Jaeger-Tim/VUB-Bachelor_Thesis_Lift_2022_2023/Photos and Videos/IMG_20230510_163319.jpg

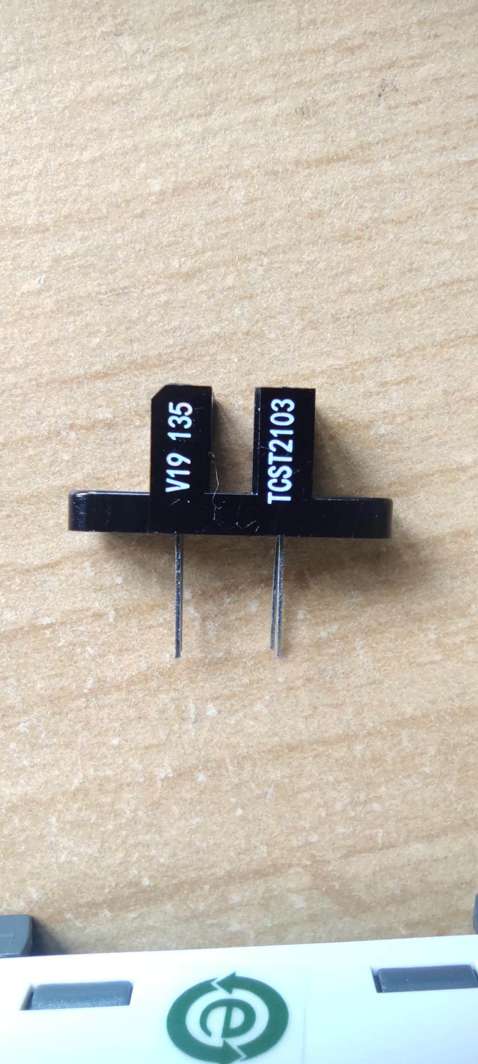
Photos and Videos/IMG_20230510_163319.jpg
