Jaeger-Tim/VUB-Bachelor_Thesis_Lift_2022_2023/README.md

This is a project for the VUB in Belgium.
