Jaeger-Tim/VUB-Bachelor_Thesis_Lift_2022_2023/Photos and Videos/2023-08-22/IMG_20230822_171855 - Copy.jpg

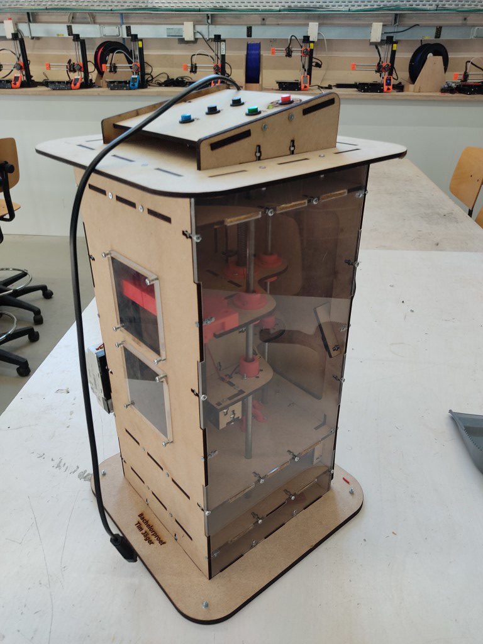
Photos and Videos/2023-08-22/IMG_20230822_171855 - Copy.jpg
