Jaeger-Tim/VUB-Bachelor_Thesis_Lift_2022_2023/Rendered_Images/Render_06_08_2023__16_59_High.png

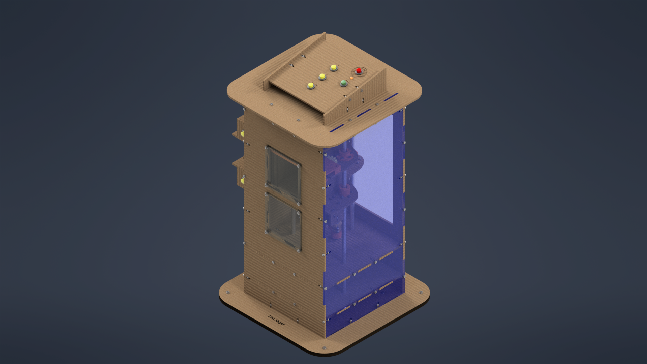
Rendered_Images/Render_06_08_2023__16_59_High.png
