Jaeger-Tim/VUB-Bachelor_Thesis_Lift_2022_2023/3D_Files/Lift_V2/V_156_1C25_STEP/V_156_1C25.step

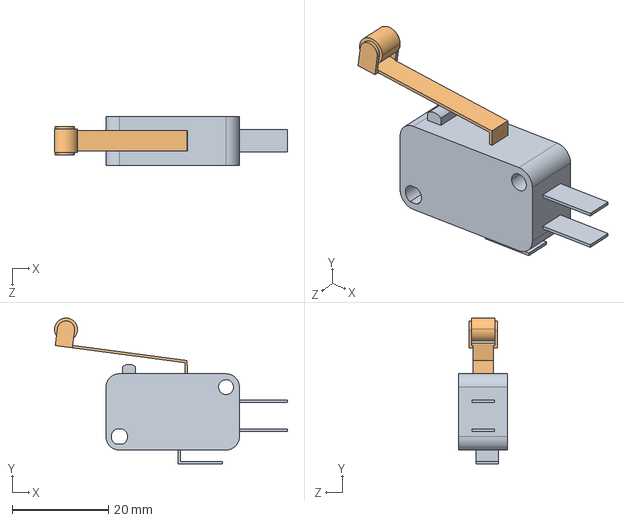
[picture p34: CAD file, 2023-08-13]
3D_Files/Lift_V2/V_156_1C25_STEP/V_156_1C25.step
48.5 x 30.4 x 10.3 mm
V_156_1C25_BASE
V_156_1C25_ACTUATOR
