Jaeger-Tim/VUB-Bachelor_Thesis_Lift_2022_2023/Production_Files/DXF/FloorButtonHolder_Side.dxf

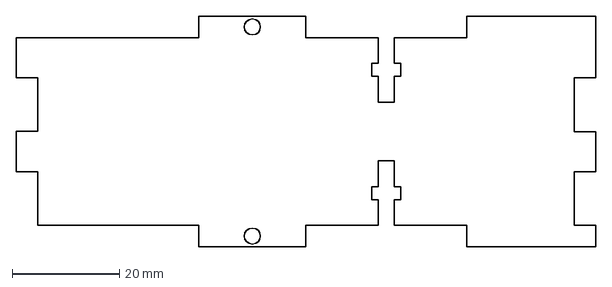
[picture p35: CAD file, 2023-08-13]
Production_Files/DXF/FloorButtonHolder_Side.dxf
108.0 x 43.0 mm
