Jaeger-Tim/VUB-Bachelor_Thesis_Lift_2022_2023/Production_Files/STL/Gear_Tight.stl

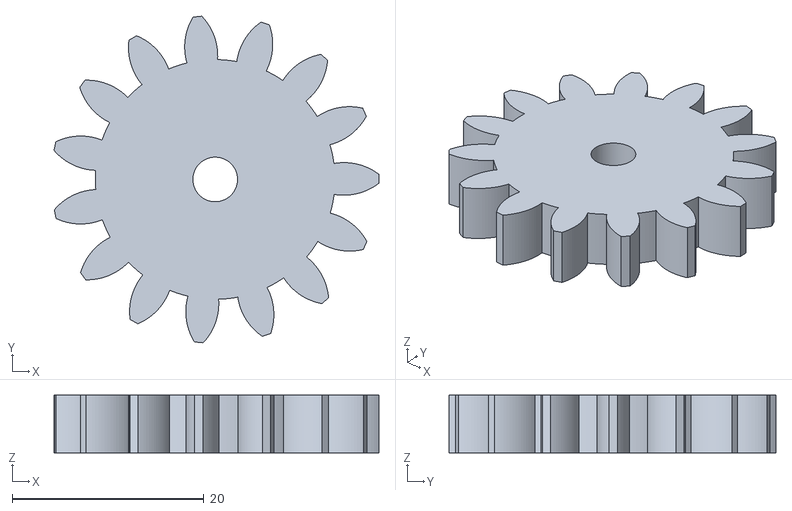
[picture p36: CAD file, 2023-08-22]
Production_Files/STL/Gear_Tight.stl
33.9 x 34.1 x 6.00
