Jaeger-Tim/VUB-Bachelor_Thesis_Lift_2022_2023/Production_Files/DXF/Wall_Left.dxf

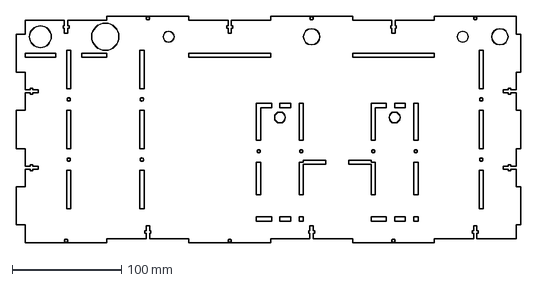
[picture p37: CAD file, 2023-08-13]
Production_Files/DXF/Wall_Left.dxf
462.0 x 208.0 mm
