Jaeger-Tim/VUB-Bachelor_Thesis_Lift_2022_2023/Production_Files/STL/Shaft_Shrunk.stl

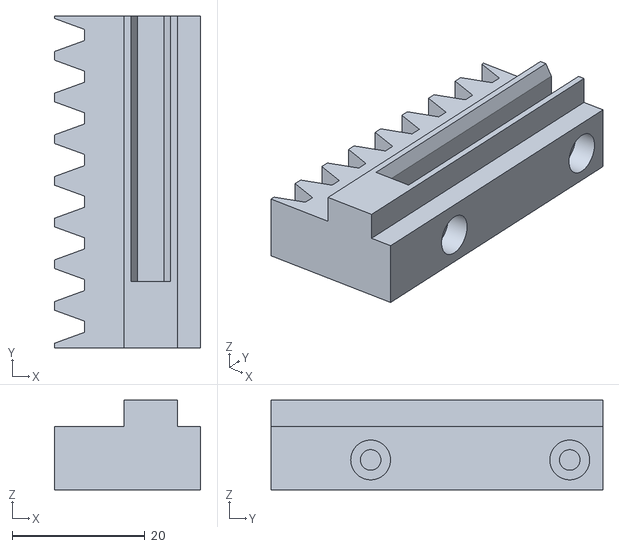
[picture p38: CAD file, 2023-08-22]
Production_Files/STL/Shaft_Shrunk.stl
22.0 x 50.0 x 13.5
