Jaeger-Tim/VUB-Bachelor_Thesis_Lift_2022_2023/Production_Files/DXF/Car_Rear.dxf

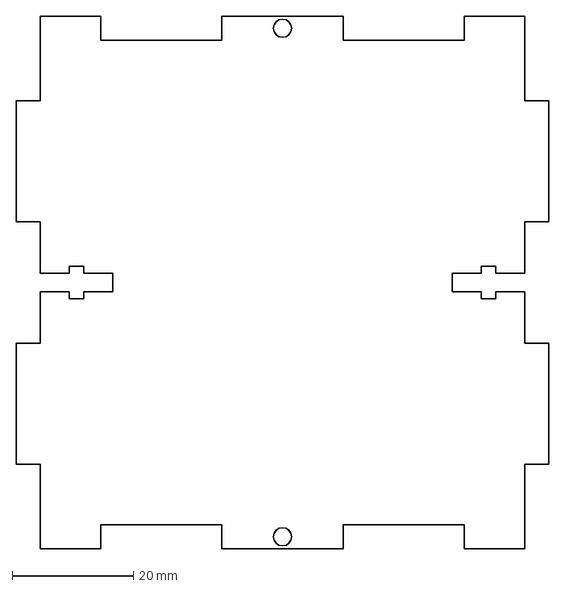
[picture p39: CAD file, 2023-08-13]
Production_Files/DXF/Car_Rear.dxf
88.0 x 88.0 mm
