Jaeger-Tim/VUB-Bachelor_Thesis_Lift_2022_2023/Production_Files/DXF/OnePlate.dxf

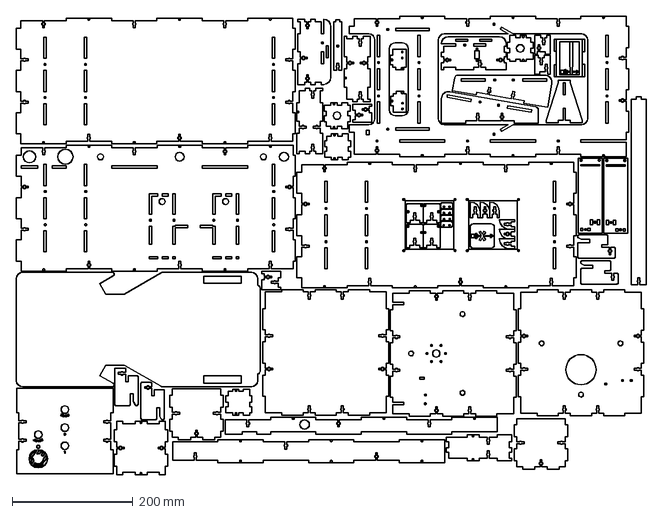
[picture p40: CAD file, 2023-08-13]
Production_Files/DXF/OnePlate.dxf
1042.2 x 757.9 mm
