Jaeger-Tim/VUB-Bachelor_Thesis_Lift_2022_2023/Production_Files/STL/Shaft_MIR.stl

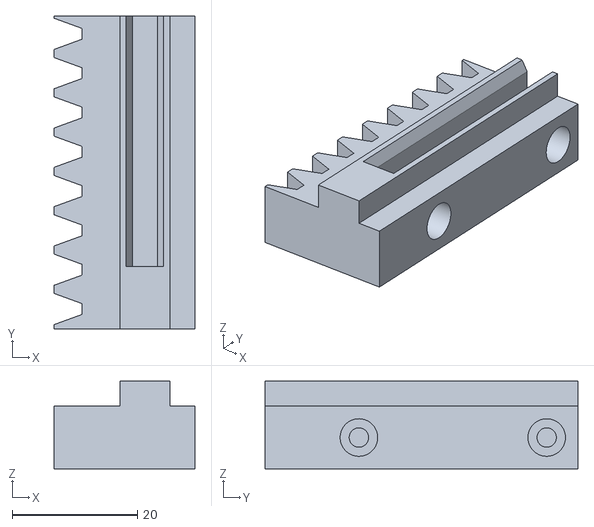
[picture p41: CAD file, 2023-08-13]
Production_Files/STL/Shaft_MIR.stl
22.5 x 50.0 x 14.0
