Jaeger-Tim/VUB-Bachelor_Thesis_Lift_2022_2023/Production_Files/STL/Receptacle.stl

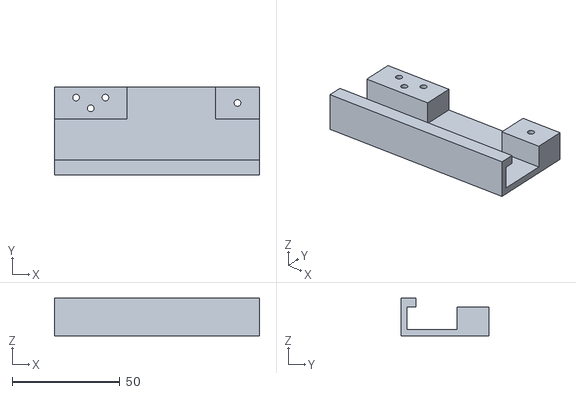
[picture p43: CAD file, 2023-08-13]
Production_Files/STL/Receptacle.stl
95.0 x 41.0 x 17.4
