Jaeger-Tim/VUB-Bachelor_Thesis_Lift_2022_2023/Production_Files/STL/Spindle_Block_Holder.stl

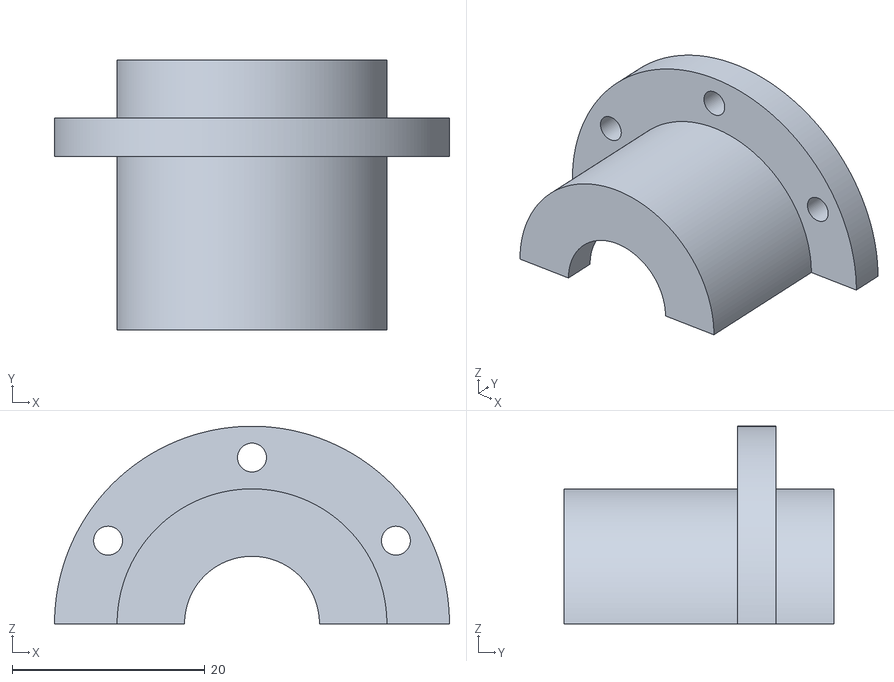
[picture p45: CAD file, 2023-08-13]
Production_Files/STL/Spindle_Block_Holder.stl
41.0 x 28.0 x 20.5
