Jaeger-Tim/VUB-Bachelor_Thesis_Lift_2022_2023/Production_Files/STL/SpindleAdaptor_A.stl

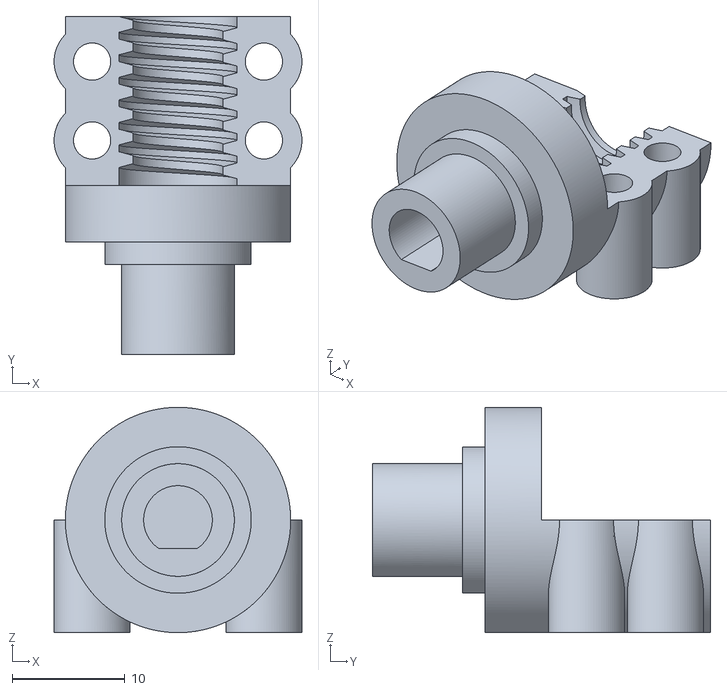
[picture p47: CAD file, 2023-08-13]
Production_Files/STL/SpindleAdaptor_A.stl
22.0 x 30.0 x 20.0
