Jaeger-Tim/VUB-Bachelor_Thesis_Lift_2022_2023/Production_Files/DXF/Cover_Back.dxf

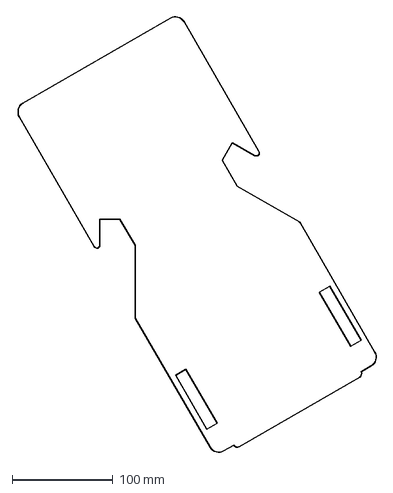
[picture p48: CAD file, 2023-08-13]
Production_Files/DXF/Cover_Back.dxf
357.6 x 433.4 mm
