Jaeger-Tim/VUB-Bachelor_Thesis_Lift_2022_2023/Production_Files/STL/LightGateCard.stl

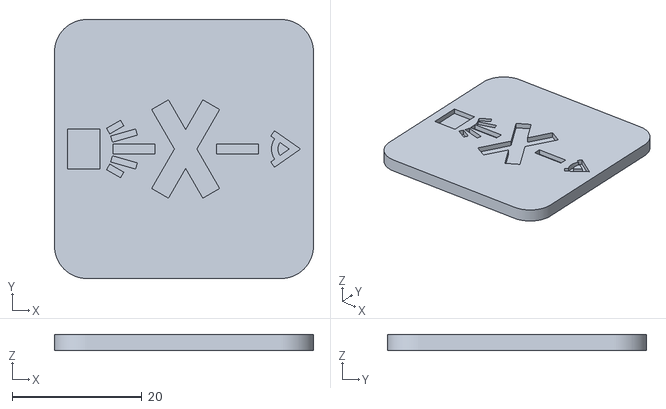
[picture p49: CAD file, 2023-08-13]
Production_Files/STL/LightGateCard.stl
40.0 x 40.0 x 2.50
