Jaeger-Tim/VUB-Bachelor_Thesis_Lift_2022_2023/Production_Files/DXF/Cover.dxf

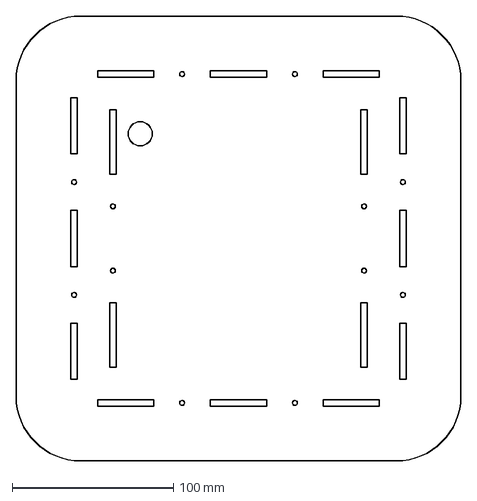
[picture p50: CAD file, 2023-08-13]
Production_Files/DXF/Cover.dxf
276.0 x 276.0 mm
