Jaeger-Tim/VUB-Bachelor_Thesis_Lift_2022_2023/Production_Files/STL/SpindleAdaptor_B.stl

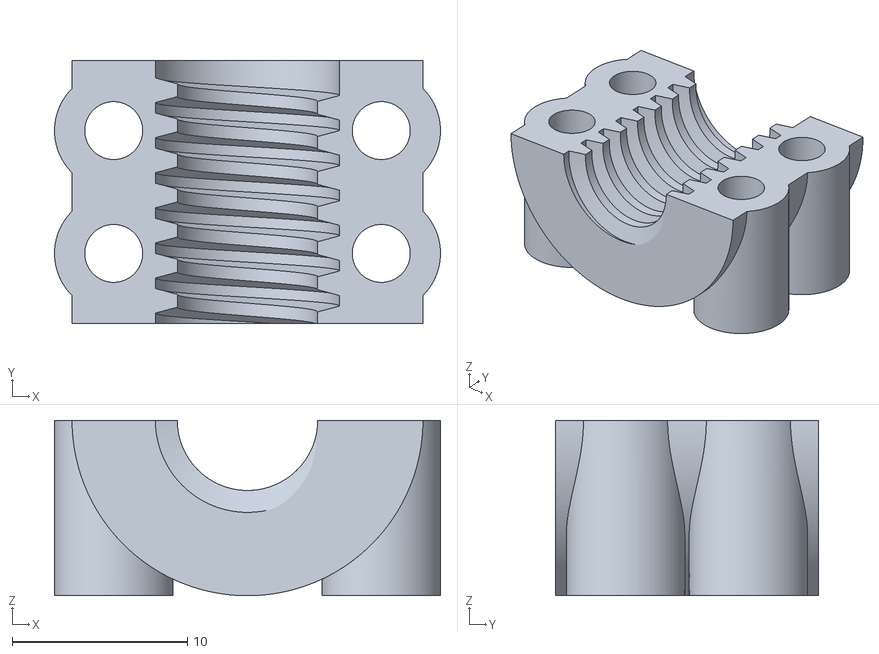
[picture p51: CAD file, 2023-08-13]
Production_Files/STL/SpindleAdaptor_B.stl
22.0 x 15.0 x 10.0
