Jaeger-Tim/VUB-Bachelor_Thesis_Lift_2022_2023/Production_Files/DXF/Car_Left.dxf

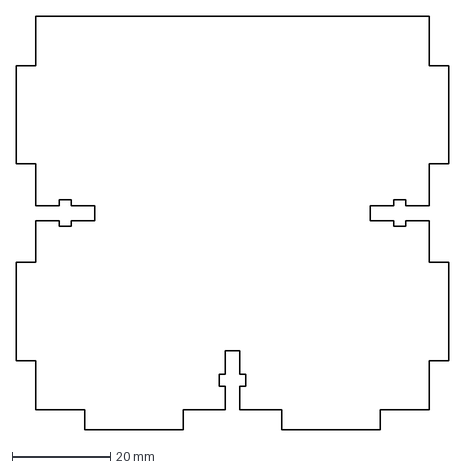
[picture p52: CAD file, 2023-08-13]
Production_Files/DXF/Car_Left.dxf
88.0 x 84.0 mm
