Jaeger-Tim/VUB-Bachelor_Thesis_Lift_2022_2023/Production_Files/STL/Bearing_Holder_MIR1.stl

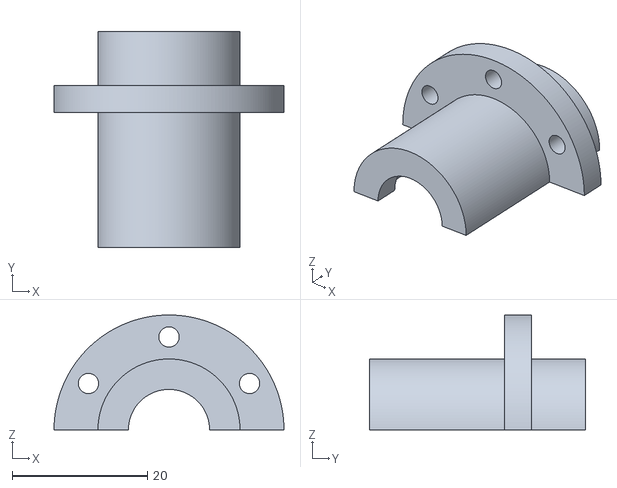
[picture p53: CAD file, 2023-08-13]
Production_Files/STL/Bearing_Holder_MIR1.stl
34.0 x 32.0 x 17.0
