Jaeger-Tim/VUB-Bachelor_Thesis_Lift_2022_2023/Production_Files/DXF/Cableduct_Side.dxf

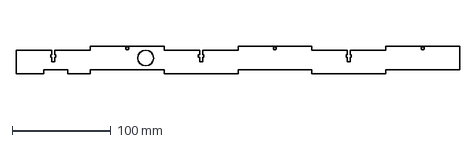
[picture p54: CAD file, 2023-08-13]
Production_Files/DXF/Cableduct_Side.dxf
450.0 x 28.0 mm
