Jaeger-Tim/VUB-Bachelor_Thesis_Lift_2022_2023/Production_Files/STL/allPrints.3mf

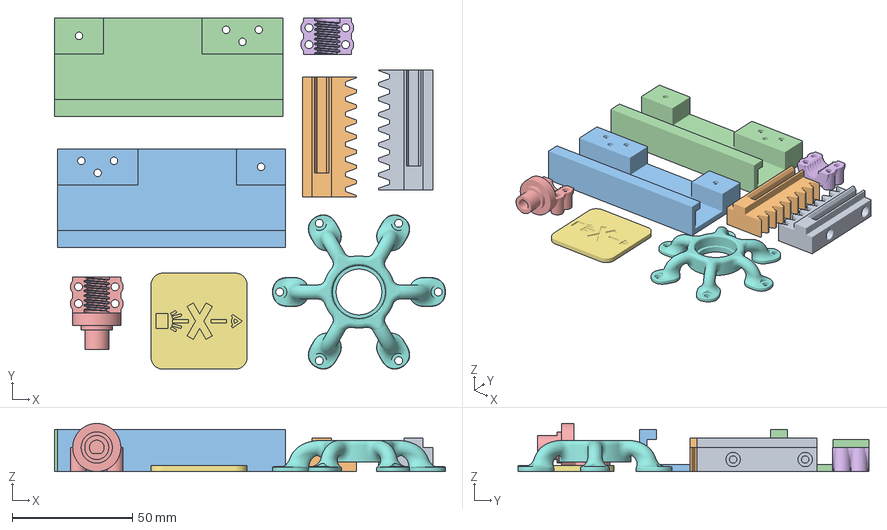
[picture p55: CAD file, 2023-08-13]
Production_Files/STL/allPrints.3mf
162.7 x 146.2 x 20.0 mm
Shaft_MIR.stl x 2
Receptacle.stl x 2
SpindleAdaptor_A.stl
SpindleAdaptor_B.stl
LightGateCard.stl
Spindle_Bearing_Holder.stl
