Jaeger-Tim/VUB-Bachelor_Thesis_Lift_2022_2023/Production_Files/DXF/Door_Right.dxf

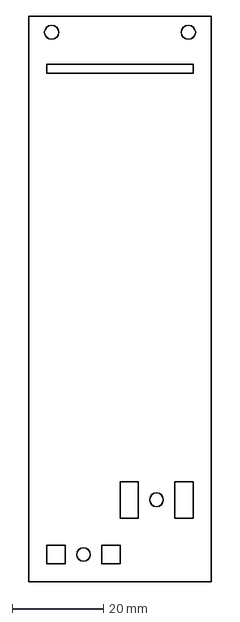
[picture p56: CAD file, 2023-08-13]
Production_Files/DXF/Door_Right.dxf
40.0 x 124.0 mm
