Jaeger-Tim/VUB-Bachelor_Thesis_Lift_2022_2023/Production_Files/DXF/Door_LimitSwitch_Holder_Side_2.dxf

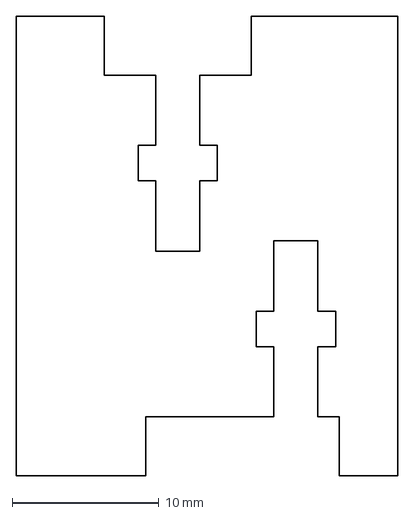
[picture p57: CAD file, 2023-08-13]
Production_Files/DXF/Door_LimitSwitch_Holder_Side_2.dxf
26.0 x 31.3 mm
