Jaeger-Tim/VUB-Bachelor_Thesis_Lift_2022_2023/Production_Files/DXF/SwitchHolder_Bottom_A.dxf

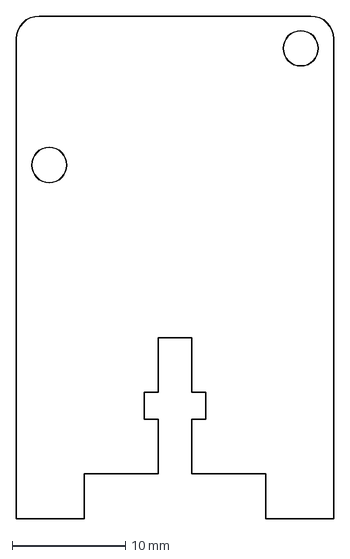
[picture p61: CAD file, 2023-08-13]
Production_Files/DXF/SwitchHolder_Bottom_A.dxf
28.0 x 44.4 mm
