Jaeger-Tim/VUB-Bachelor_Thesis_Lift_2022_2023/Production_Files/DXF/Cart_Floor.dxf

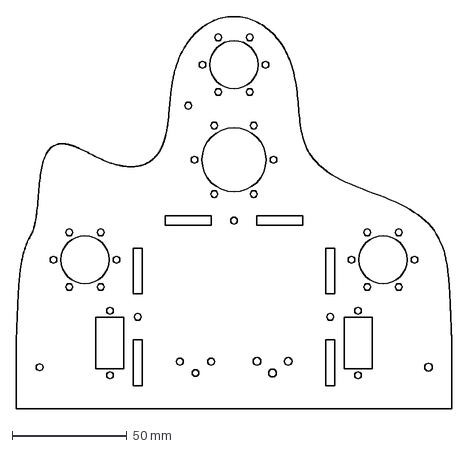
[picture p62: CAD file, 2023-08-13]
Production_Files/DXF/Cart_Floor.dxf
190.0 x 171.0 mm
