Jaeger-Tim/VUB-Bachelor_Thesis_Lift_2022_2023/Production_Files/DXF/SwitchHolder_Bottom_B.dxf

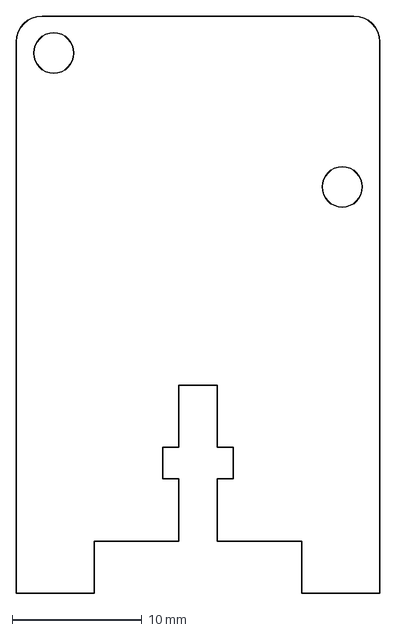
[picture p63: CAD file, 2023-08-13]
Production_Files/DXF/SwitchHolder_Bottom_B.dxf
28.0 x 44.4 mm
