Jaeger-Tim/VUB-Bachelor_Thesis_Lift_2022_2023/Production_Files/DXF/Cableduct_Cover.dxf

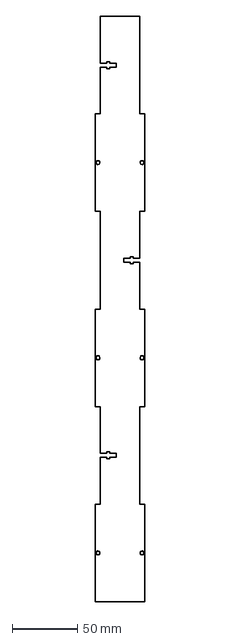
[picture p64: CAD file, 2023-08-13]
Production_Files/DXF/Cableduct_Cover.dxf
38.0 x 450.0 mm
