Jaeger-Tim/VUB-Bachelor_Thesis_Lift_2022_2023/Production_Files/DXF/Wall_Rear.dxf

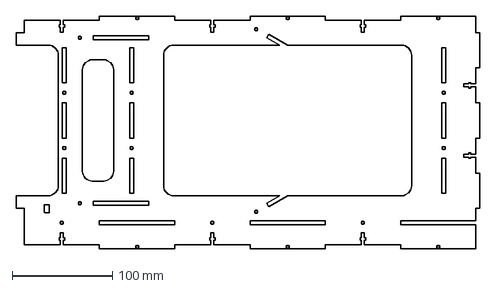
[picture p65: CAD file, 2023-08-13]
Production_Files/DXF/Wall_Rear.dxf
462.0 x 232.0 mm
