Jaeger-Tim/VUB-Bachelor_Thesis_Lift_2022_2023/Production_Files/DXF/LightGate_Plate.dxf

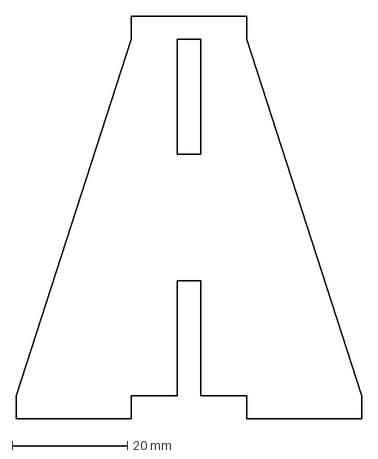
[picture p66: CAD file, 2023-08-13]
Production_Files/DXF/LightGate_Plate.dxf
60.0 x 70.0 mm
