Jaeger-Tim/VUB-Bachelor_Thesis_Lift_2022_2023/Production_Files/DXF/Door_LimitSwitch_Offset.dxf

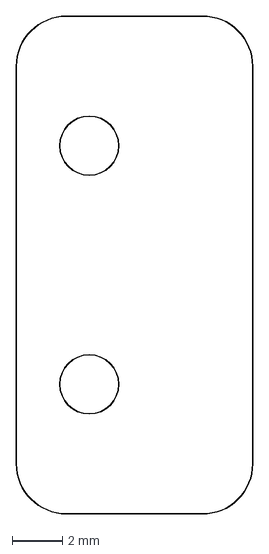
[picture p67: CAD file, 2023-08-13]
Production_Files/DXF/Door_LimitSwitch_Offset.dxf
9.40 x 19.8 mm
