Jaeger-Tim/VUB-Bachelor_Thesis_Lift_2022_2023/Production_Files/DXF/Door_LimitSwitch_Holder_Plate_MIR.dxf

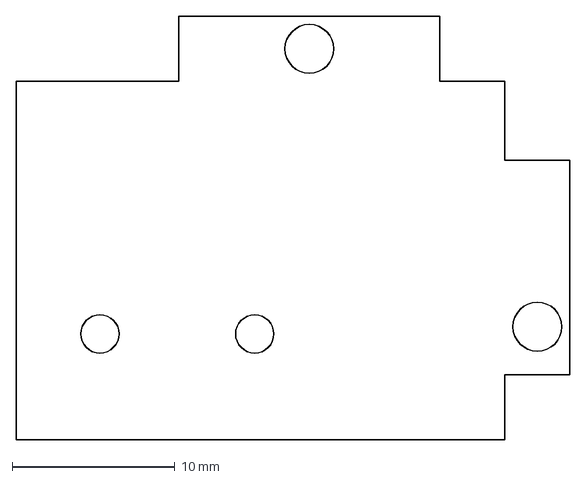
[picture p68: CAD file, 2023-08-13]
Production_Files/DXF/Door_LimitSwitch_Holder_Plate_MIR.dxf
34.0 x 26.0 mm
