Jaeger-Tim/VUB-Bachelor_Thesis_Lift_2022_2023/Production_Files/DXF/Floor.dxf

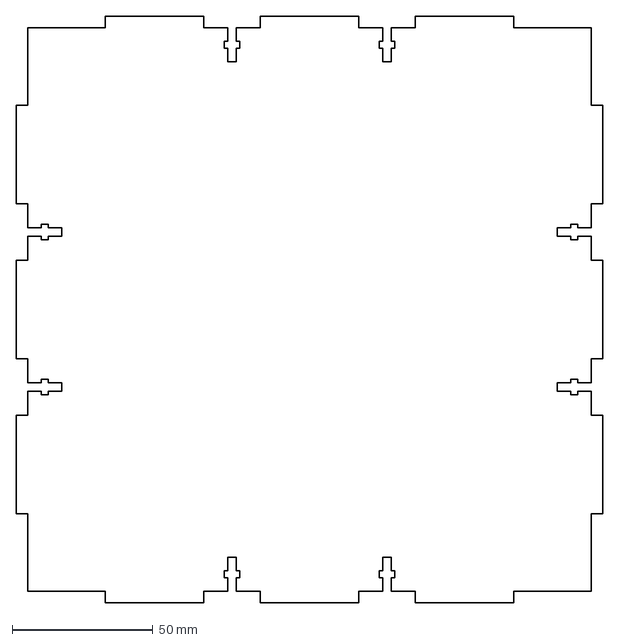
[picture p73: CAD file, 2023-08-13]
Production_Files/DXF/Floor.dxf
208.0 x 208.0 mm
