Jaeger-Tim/VUB-Bachelor_Thesis_Lift_2022_2023/Production_Files/DXF/Reed_Rail.dxf

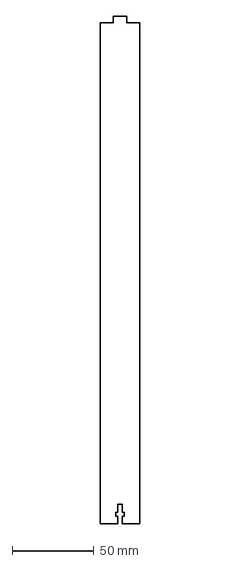
[picture p74: CAD file, 2023-08-13]
Production_Files/DXF/Reed_Rail.dxf
24.0 x 311.0 mm
