Jaeger-Tim/VUB-Bachelor_Thesis_Lift_2022_2023/Production_Files/DXF/Door_LimitSwitch_Holder_Side_1.dxf

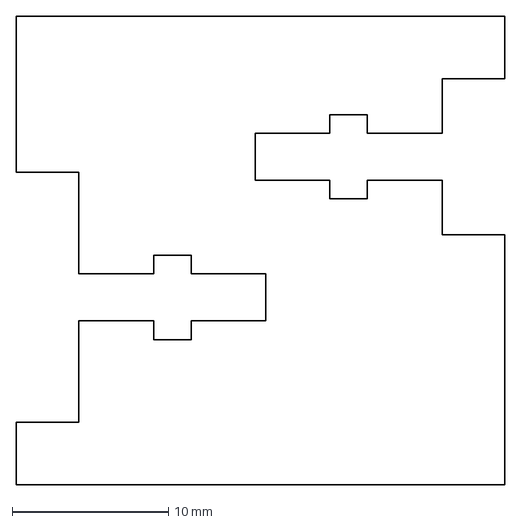
[picture p75: CAD file, 2023-08-13]
Production_Files/DXF/Door_LimitSwitch_Holder_Side_1.dxf
31.3 x 30.0 mm
