Jaeger-Tim/VUB-Bachelor_Thesis_Lift_2022_2023/Production_Files/DXF/Baseplate_Bottom.dxf

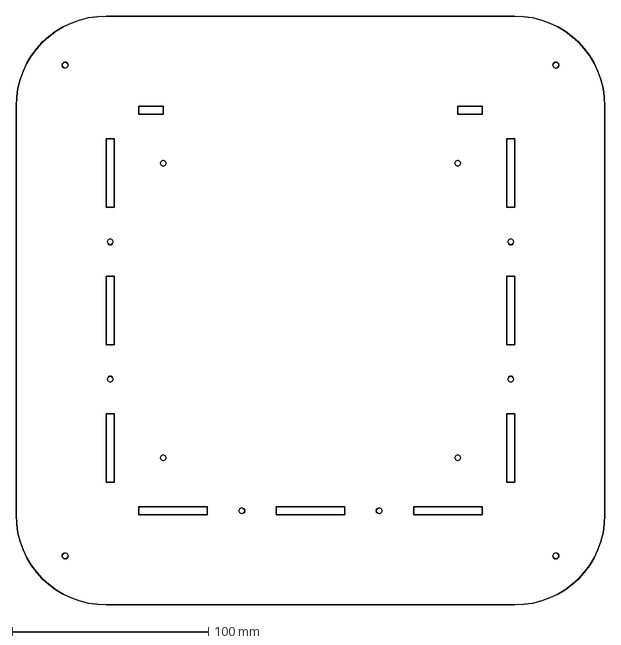
[picture p77: CAD file, 2023-08-13]
Production_Files/DXF/Baseplate_Bottom.dxf
300.0 x 300.0 mm
