Jaeger-Tim/VUB-Bachelor_Thesis_Lift_2022_2023/Production_Files/DXF/FloorButtonHolder_Front.dxf

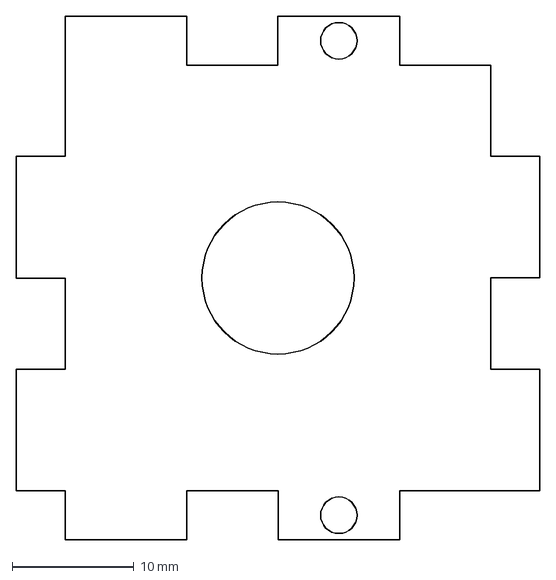
[picture p80: CAD file, 2023-08-13]
Production_Files/DXF/FloorButtonHolder_Front.dxf
43.0 x 43.0 mm
