Jaeger-Tim/VUB-Bachelor_Thesis_Lift_2022_2023/Production_Files/DXF/Pannel.dxf

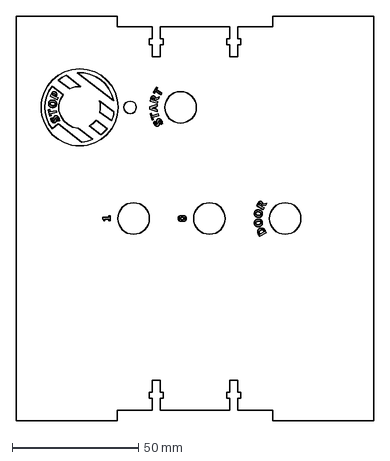
[picture p82: CAD file, 2023-08-13]
Production_Files/DXF/Pannel.dxf
141.4 x 160.0 mm
