Jaeger-Tim/VUB-Bachelor_Thesis_Lift_2022_2023/Production_Files/DXF/SwitchHolder_Top_B.dxf

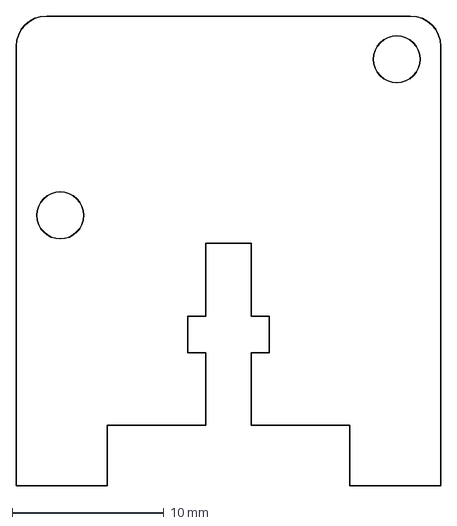
[picture p83: CAD file, 2023-08-13]
Production_Files/DXF/SwitchHolder_Top_B.dxf
28.0 x 31.0 mm
