Jaeger-Tim/VUB-Bachelor_Thesis_Lift_2022_2023/Production_Files/DXF/CoverHolder_Left.dxf

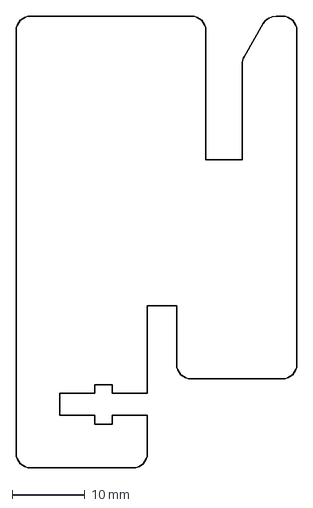
[picture p84: CAD file, 2023-08-13]
Production_Files/DXF/CoverHolder_Left.dxf
38.5 x 61.9 mm
