Jaeger-Tim/VUB-Bachelor_Thesis_Lift_2022_2023/Production_Files/DXF/Door_LimitSwitch_Holder_Side_2_B.dxf

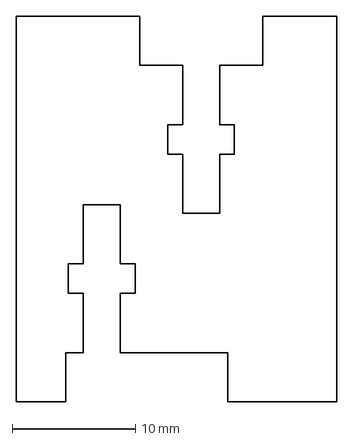
[picture p85: CAD file, 2023-08-13]
Production_Files/DXF/Door_LimitSwitch_Holder_Side_2_B.dxf
26.0 x 31.3 mm
