Jaeger-Tim/VUB-Bachelor_Thesis_Lift_2022_2023/Production_Files/DXF/LightGate_Door.dxf

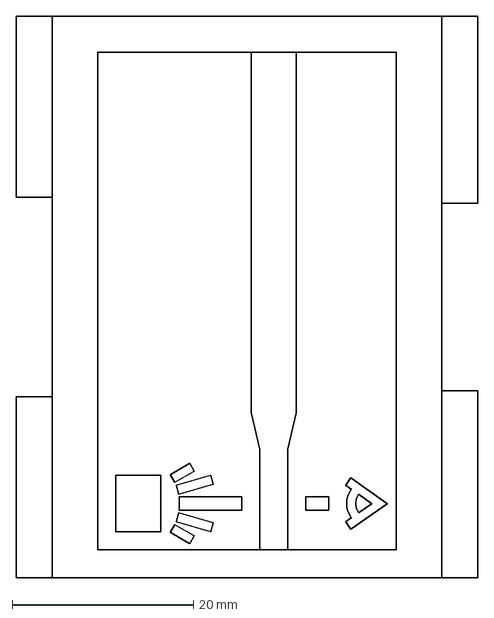
[picture p86: CAD file, 2023-08-13]
Production_Files/DXF/LightGate_Door.dxf
51.0 x 62.0 mm
