Jaeger-Tim/VUB-Bachelor_Thesis_Lift_2022_2023/Production_Files/DXF/Baseplate_Top.dxf

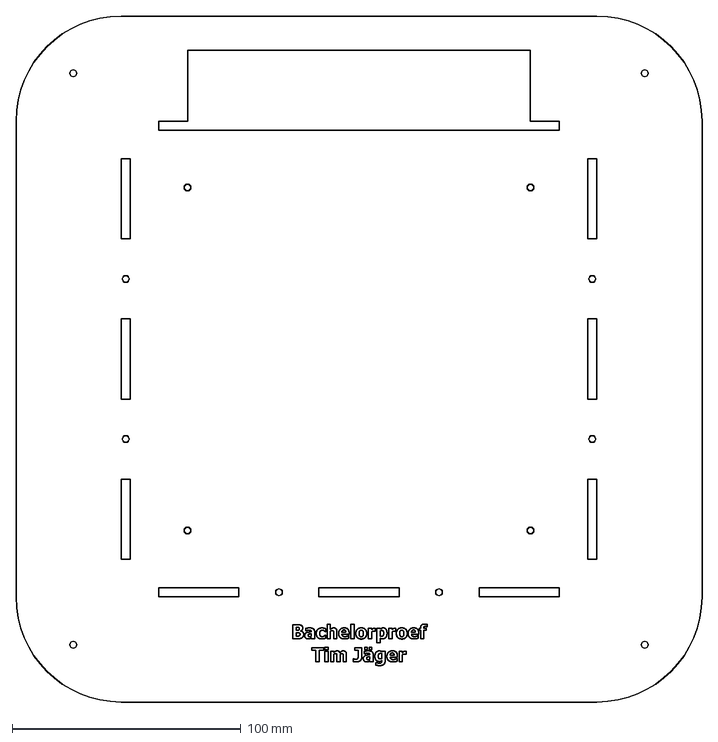
[picture p87: CAD file, 2023-08-13]
Production_Files/DXF/Baseplate_Top.dxf
300.0 x 300.0 mm
