Jaeger-Tim/VUB-Bachelor_Thesis_Lift_2022_2023/Production_Files/DXF/Magnet_Holder.dxf

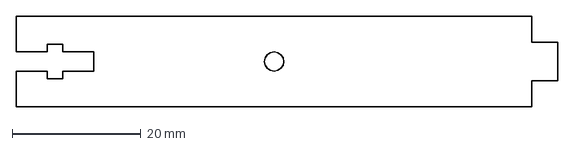
[picture p88: CAD file, 2023-08-13]
Production_Files/DXF/Magnet_Holder.dxf
84.0 x 14.0 mm
