Jaeger-Tim/VUB-Bachelor_Thesis_Lift_2022_2023/Production_Files/DXF/FloorButtonHolder_Bottom_A.dxf

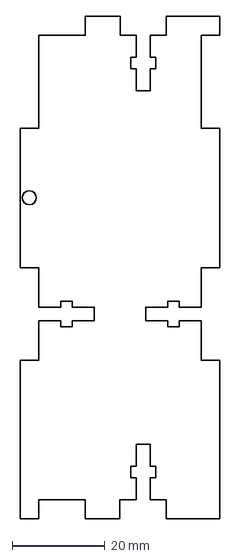
[picture p89: CAD file, 2023-08-13]
Production_Files/DXF/FloorButtonHolder_Bottom_A.dxf
43.0 x 108.0 mm
