Jaeger-Tim/VUB-Bachelor_Thesis_Lift_2022_2023/Production_Files/DXF/Wall_Front.dxf

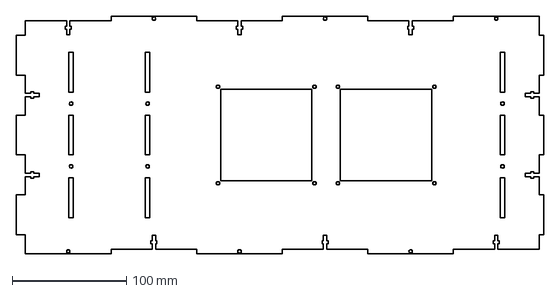
[picture p90: CAD file, 2023-08-13]
Production_Files/DXF/Wall_Front.dxf
462.0 x 208.0 mm
