Jaeger-Tim/VUB-Bachelor_Thesis_Lift_2022_2023/Production_Files/DXF/Pannel_Side_Left.dxf

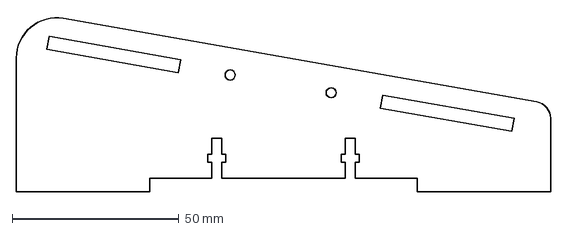
[picture p91: CAD file, 2023-08-13]
Production_Files/DXF/Pannel_Side_Left.dxf
160.0 x 52.5 mm
