Jaeger-Tim/VUB-Bachelor_Thesis_Lift_2022_2023/Production_Files/DXF/Lever.dxf

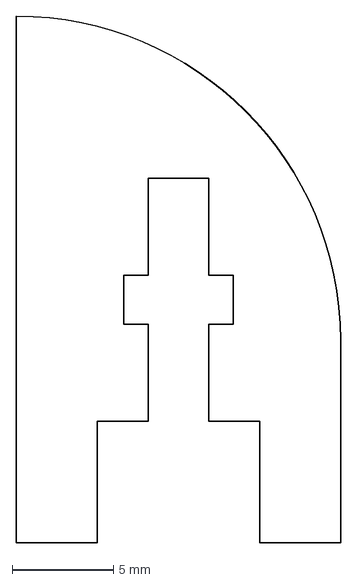
[picture p92: CAD file, 2023-08-13]
Production_Files/DXF/Lever.dxf
16.0 x 26.0 mm
