Jaeger-Tim/VUB-Bachelor_Thesis_Lift_2022_2023/Production_Files/DXF/FloorButtonHOlder_Back.dxf

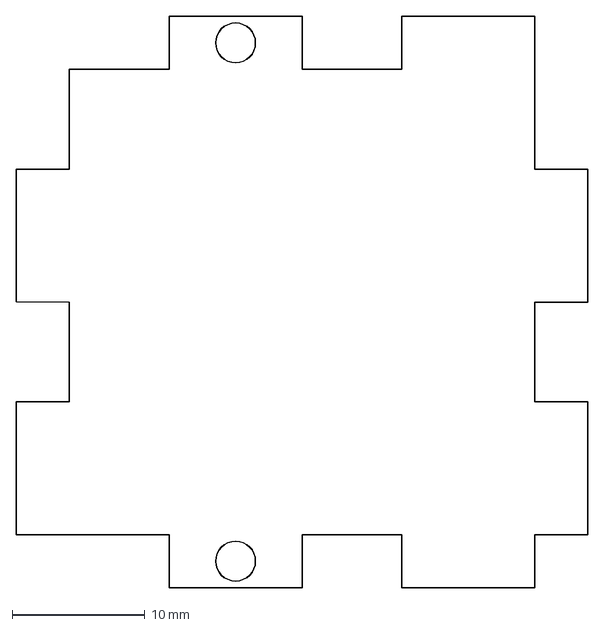
[picture p93: CAD file, 2023-08-13]
Production_Files/DXF/FloorButtonHOlder_Back.dxf
43.0 x 43.0 mm
