Jaeger-Tim/VUB-Bachelor_Thesis_Lift_2022_2023/(list of files, cad)

Other CAD files:
Production_Files/STL/Gear.stl
Production_Files/STL/Bearing_Holder.stl
3D_Files/Lift_V2/Baseplate_V1.ipt
3D_Files/Lift_V2/Baseplate_face.ipt
3D_Files/Lift_V2/Bearing_ASM.iam
3D_Files/Lift_V2/Bearing_ASM_MIR.iam
3D_Files/Lift_V2/Bearing_ASM_MIR1.iam
3D_Files/Lift_V2/Bearing_Holder.ipt
3D_Files/Lift_V2/Bearing_Holder_MIR.ipt
3D_Files/Lift_V2/Bearing_Holder_MIR1.ipt
3D_Files/Lift_V2/Button_Green.ipt
3D_Files/Lift_V2/Button_Red.ipt
3D_Files/Lift_V2/Button_Yellow.ipt
3D_Files/Lift_V2/Cableduct_Cover.ipt
3D_Files/Lift_V2/Cableduct_Side.ipt
3D_Files/Lift_V2/Car_ASM.iam
3D_Files/Lift_V2/Car_Left.ipt
3D_Files/Lift_V2/Car_Rear.ipt
3D_Files/Lift_V2/Cart_Floor.ipt
3D_Files/Lift_V2/Cart_Floor_Bottom.ipt
3D_Files/Lift_V2/Cover.ipt
3D_Files/Lift_V2/CoverHolder.ipt
3D_Files/Lift_V2/Cover_Back.ipt
3D_Files/Lift_V2/Door.ipt
3D_Files/Lift_V2/Door_LimitSwitch_Holder_Plate.ipt
3D_Files/Lift_V2/Door_LimitSwitch_Holder_Plate_MIR.ipt
3D_Files/Lift_V2/Door_LimitSwitch_Holder_Side_1.ipt
3D_Files/Lift_V2/Door_LimitSwitch_Holder_Side_1_MIR.ipt
3D_Files/Lift_V2/Door_LimitSwitch_Holder_Side_2.ipt
3D_Files/Lift_V2/Door_LimitSwitch_Holder_Side_2_MIR.ipt
3D_Files/Lift_V2/Door_LimitSwitch_Offset.ipt
3D_Files/Lift_V2/Door_MIR.ipt
3D_Files/Lift_V2/Floor.ipt
3D_Files/Lift_V2/FloorButtonHolder_Back.ipt
3D_Files/Lift_V2/FloorButtonHolder_Bottom_A.ipt
3D_Files/Lift_V2/FloorButtonHolder_Bottom_B.ipt
3D_Files/Lift_V2/FloorButtonHolder_Front.ipt
3D_Files/Lift_V2/FloorButtonHolder_Side.ipt
3D_Files/Lift_V2/FloorButtonHolder_Top_A.ipt
3D_Files/Lift_V2/FloorButtonHolder_Top_B.ipt
3D_Files/Lift_V2/Floor_Bottom.ipt
3D_Files/Lift_V2/Floor_Top.ipt
3D_Files/Lift_V2/Gear.ipt
3D_Files/Lift_V2/Gear_MIR.ipt
3D_Files/Lift_V2/Guide Rod.ipt
3D_Files/Lift_V2/ISO 1207 - M3 x 12.ipt
3D_Files/Lift_V2/ISO 4032 - M3 - ISO.ipt
3D_Files/Lift_V2/ISO 7089 - 3 - 140 HV(1).ipt
3D_Files/Lift_V2/LED5mm.ipt
3D_Files/Lift_V2/Lever.ipt
3D_Files/Lift_V2/Lever_MIR.ipt
3D_Files/Lift_V2/Lift_V2.iam
3D_Files/Lift_V2/LightGateCard.ipt
3D_Files/Lift_V2/LightGate_Door.ipt
3D_Files/Lift_V2/LightGate_Plate.ipt
3D_Files/Lift_V2/LimitSwitch_Big.iam
3D_Files/Lift_V2/LimitSwitch_Small.ipt
3D_Files/Lift_V2/LinearBearing.ipt
3D_Files/Lift_V2/LinearBearing_MIR.ipt
3D_Files/Lift_V2/LinearBearing_MIR1.ipt
3D_Files/Lift_V2/Magnet_Holder.ipt
3D_Files/Lift_V2/Motor24V.ipt
3D_Files/Lift_V2/OldVersions/Baseplate_V1.0009.ipt
3D_Files/Lift_V2/OldVersions/Baseplate_deriveTest.0003.ipt
3D_Files/Lift_V2/OldVersions/Baseplate_face.0008.ipt
3D_Files/Lift_V2/OldVersions/Bearing_ASM.0004.iam
3D_Files/Lift_V2/OldVersions/Bearing_ASM_MIR1.0002.iam
3D_Files/Lift_V2/OldVersions/Bearing_Holder.0003.ipt
3D_Files/Lift_V2/OldVersions/Bearing_Holder_MIR1.0001.ipt
3D_Files/Lift_V2/OldVersions/Cableduct_Cover.0002.ipt
3D_Files/Lift_V2/OldVersions/Cableduct_Side.0004.ipt
3D_Files/Lift_V2/OldVersions/Car_ASM.0057.iam
3D_Files/Lift_V2/OldVersions/Car_Left.0003.ipt
3D_Files/Lift_V2/OldVersions/Car_Rear.0006.ipt
3D_Files/Lift_V2/OldVersions/Cart_Floor.0015.ipt
3D_Files/Lift_V2/OldVersions/Cart_Floor_Bottom.0017.ipt
3D_Files/Lift_V2/OldVersions/Cover.0003.ipt
3D_Files/Lift_V2/OldVersions/CoverHolder.0008.ipt
3D_Files/Lift_V2/OldVersions/Cover_Back.0003.ipt
3D_Files/Lift_V2/OldVersions/Door.0018.ipt
3D_Files/Lift_V2/OldVersions/Door_LimitSwitch_Holder_Plate.0002.ipt
3D_Files/Lift_V2/OldVersions/Door_LimitSwitch_Holder_Plate_MIR.0001.ipt
3D_Files/Lift_V2/OldVersions/Door_LimitSwitch_Holder_Side_1.0003.ipt
3D_Files/Lift_V2/OldVersions/Door_LimitSwitch_Holder_Side_1_MIR.0001.ipt
3D_Files/Lift_V2/OldVersions/Door_LimitSwitch_Holder_Side_2.0003.ipt
3D_Files/Lift_V2/OldVersions/Door_LimitSwitch_Holder_Side_2_MIR.0001.ipt
3D_Files/Lift_V2/OldVersions/Door_LimitSwitch_Offset.0004.ipt
3D_Files/Lift_V2/OldVersions/Door_MIR.0008.ipt
3D_Files/Lift_V2/OldVersions/Floor.0005.ipt
3D_Files/Lift_V2/OldVersions/FloorButtonHolder_Back.0006.ipt
3D_Files/Lift_V2/OldVersions/FloorButtonHolder_Bottom_A.0005.ipt
3D_Files/Lift_V2/OldVersions/FloorButtonHolder_Bottom_B.0009.ipt
3D_Files/Lift_V2/OldVersions/FloorButtonHolder_Front.0005.ipt
3D_Files/Lift_V2/OldVersions/FloorButtonHolder_Side.0011.ipt
3D_Files/Lift_V2/OldVersions/FloorButtonHolder_Top_A.0006.ipt
3D_Files/Lift_V2/OldVersions/FloorButtonHolder_Top_B.0013.ipt
3D_Files/Lift_V2/OldVersions/Floor_Bottom.0012.ipt
3D_Files/Lift_V2/OldVersions/Floor_Top.0009.ipt
3D_Files/Lift_V2/OldVersions/Gear.0010.ipt
3D_Files/Lift_V2/OldVersions/Guide Rod.0003.ipt
3D_Files/Lift_V2/OldVersions/Lever.0009.ipt
3D_Files/Lift_V2/OldVersions/Lift_V2.0145.iam
3D_Files/Lift_V2/OldVersions/LightGateCard.0013.ipt
3D_Files/Lift_V2/OldVersions/LightGate_Door.0021.ipt
3D_Files/Lift_V2/OldVersions/LightGate_Plate.0005.ipt
3D_Files/Lift_V2/OldVersions/LimitSwitch_Big.0004.iam
3D_Files/Lift_V2/OldVersions/LimitSwitch_Small.0003.ipt
3D_Files/Lift_V2/OldVersions/LinearBearing.0002.ipt
3D_Files/Lift_V2/OldVersions/Magnet_Holder.0002.ipt
3D_Files/Lift_V2/OldVersions/Motor24V.0002.ipt
3D_Files/Lift_V2/OldVersions/Panel.0011.ipt
3D_Files/Lift_V2/OldVersions/Pannel_Side.0004.ipt
3D_Files/Lift_V2/OldVersions/Protector_80x80.0002.ipt
3D_Files/Lift_V2/OldVersions/Receptacle.0017.ipt
3D_Files/Lift_V2/OldVersions/Receptacle_MIR.0002.ipt
3D_Files/Lift_V2/OldVersions/Reed_Rail.0002.ipt
3D_Files/Lift_V2/OldVersions/Servo_Motor.0004.ipt
3D_Files/Lift_V2/OldVersions/Shaft.0012.ipt
3D_Files/Lift_V2/OldVersions/Shaft_MIR.0002.ipt
3D_Files/Lift_V2/OldVersions/SpindleAdaptor_A.0015.ipt
3D_Files/Lift_V2/OldVersions/SpindleAdaptor_B.0010.ipt
3D_Files/Lift_V2/OldVersions/SpindleBlock.0003.ipt
3D_Files/Lift_V2/OldVersions/Spindle_Block_ASM.0004.iam
3D_Files/Lift_V2/OldVersions/Spindle_Block_ASM_MIR.0002.iam
3D_Files/Lift_V2/OldVersions/Spindle_Block_Holder.0001.ipt
3D_Files/Lift_V2/OldVersions/Spindle_Block_Holder_MIR.0001.ipt
3D_Files/Lift_V2/OldVersions/Spindle_Rod.0006.ipt
3D_Files/Lift_V2/OldVersions/SwitchHolder_Bottom.0006.ipt
3D_Files/Lift_V2/OldVersions/SwitchHolder_Top.0004.ipt
3D_Files/Lift_V2/OldVersions/Wall.0010.ipt
3D_Files/Lift_V2/OldVersions/Wall_Front.0010.ipt
3D_Files/Lift_V2/OldVersions/Wall_Left.0012.ipt
3D_Files/Lift_V2/OldVersions/Wall_rear.0011.ipt
3D_Files/Lift_V2/Panel.ipt
3D_Files/Lift_V2/Pannel_Side.ipt
3D_Files/Lift_V2/Protector_80x80.ipt
3D_Files/Lift_V2/Receptacle.ipt
3D_Files/Lift_V2/Receptacle_MIR.ipt
3D_Files/Lift_V2/Reed_Rail.ipt
3D_Files/Lift_V2/Servo_Motor.ipt
3D_Files/Lift_V2/Servo_Motor_MIR.ipt
3D_Files/Lift_V2/Shaft.ipt
3D_Files/Lift_V2/Shaft_MIR.ipt
3D_Files/Lift_V2/SpindleAdaptor_A.ipt
3D_Files/Lift_V2/SpindleAdaptor_B.ipt
3D_Files/Lift_V2/SpindleBlock.ipt
3D_Files/Lift_V2/SpindleBlock_MIR.ipt
3D_Files/Lift_V2/Spindle_Block_ASM.iam
3D_Files/Lift_V2/Spindle_Block_ASM_MIR.iam
3D_Files/Lift_V2/Spindle_Block_Holder.ipt
3D_Files/Lift_V2/Spindle_Block_Holder_MIR.ipt
3D_Files/Lift_V2/Spindle_Rod.ipt
3D_Files/Lift_V2/SwitchHolder_Bottom.ipt
3D_Files/Lift_V2/SwitchHolder_Top.ipt
3D_Files/Lift_V2/V_156_1C25_STEP/V_156_1C25/OldVersions/V_156_1C25_ACTUATOR.0001.ipt
3D_Files/Lift_V2/V_156_1C25_STEP/V_156_1C25/OldVersions/V_156_1C25_BASE.0001.ipt
3D_Files/Lift_V2/V_156_1C25_STEP/V_156_1C25/V_156_1C25_ACTUATOR.ipt
3D_Files/Lift_V2/V_156_1C25_STEP/V_156_1C25/V_156_1C25_BASE.ipt
3D_Files/Lift_V2/Wall.ipt
3D_Files/Lift_V2/Wall_Front.ipt
3D_Files/Lift_V2/Wall_Left.ipt
3D_Files/Lift_V2/Wall_Right.ipt
3D_Files/Lift_V2/Wall_rear.ipt
Production_Files/DXF/LightGateCard.dxf
Production_Files/DXF/OnePlate.idw
