Jaeger-Tim/VUB-Bachelor_Thesis_Lift_2022_2023/Elektronica/SCH_VUB Bachelorproef_2023-08-22.pdf

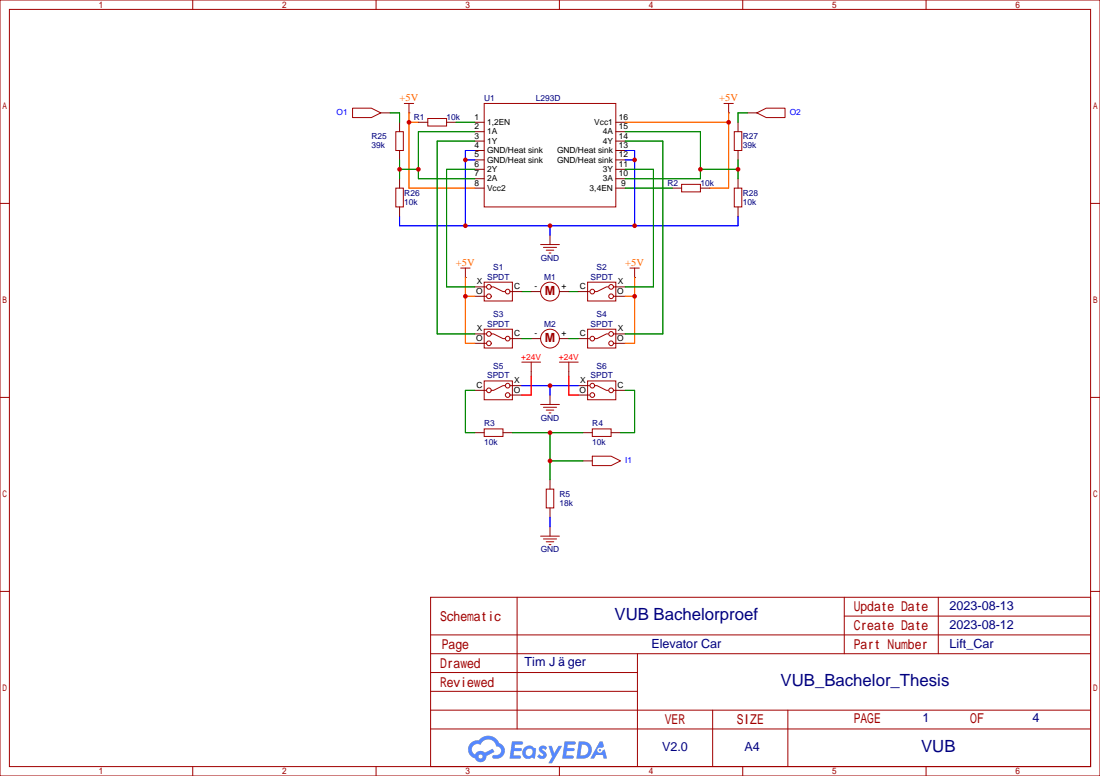
[picture p94: page 1]

I1 1

O4 14

I3 3

O2 12

IB 5

10 ID 7

IE 8
+

9

IC 6

O1 11

I4 4

O3 13

I2 2

O+ 15

CD12S 24V/DC

PLC1 +24V

+24V

GND

O1 | O2

ID

I1

O3 | O4 I2
I3 | I4
IB | IE

IC

### Reviewed

### Drawed

### Create Date Part Number

### Schematic

### Update Date

### Page

## Tim J ger

# VUB_Bachelor_Thesis

2023-08-12

# 2023-08-12 VUB Bachelorproef

## Lift_PLC

## PLC

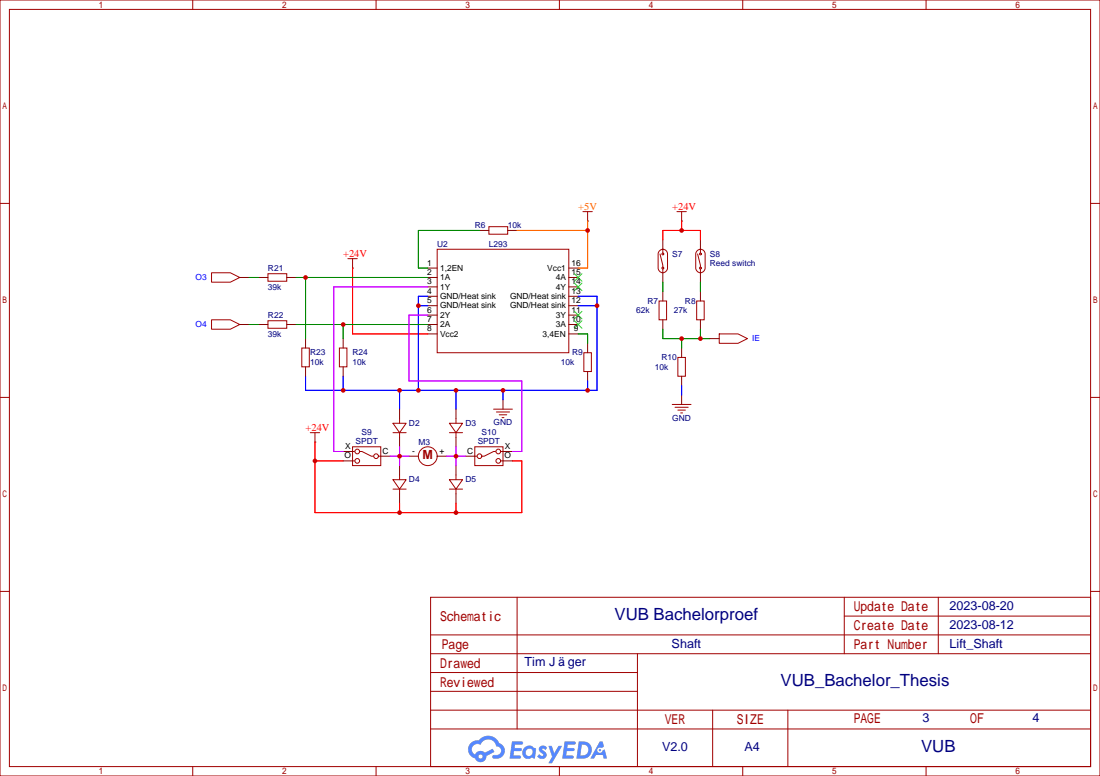
[picture p95: page 3]

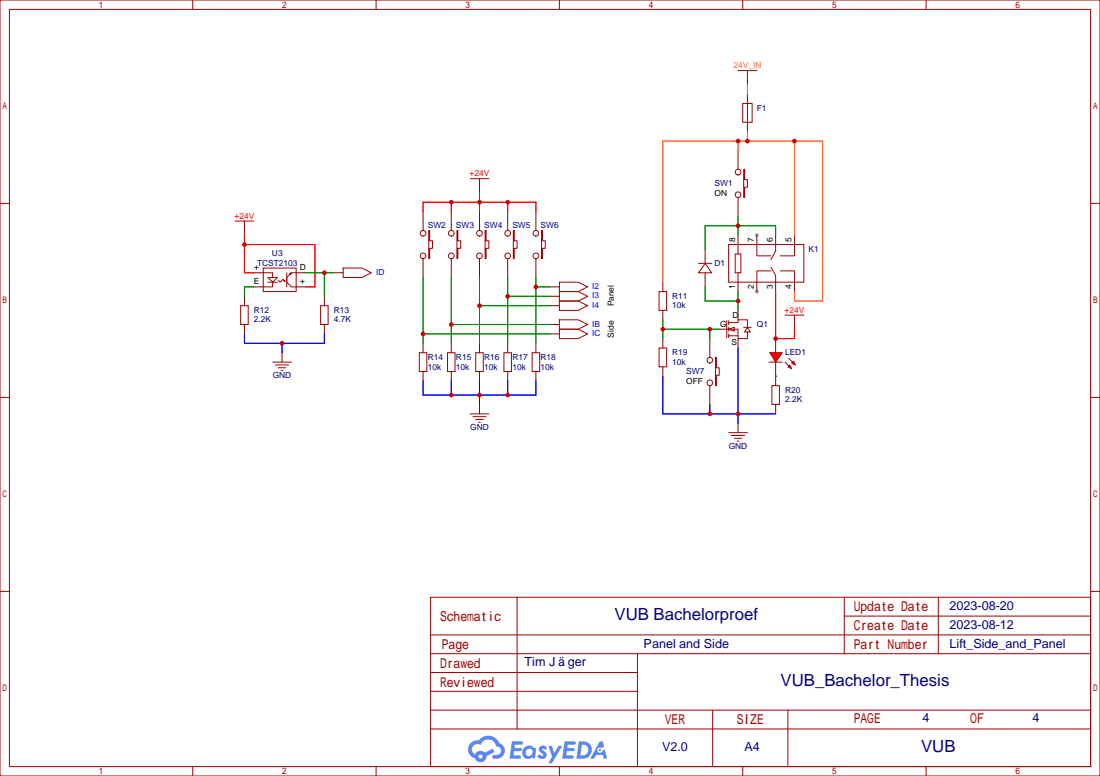
[picture p96: page 4]
