Jaeger-Tim/VUB-Bachelor_Thesis_Lift_2022_2023/(commit log)

2023-08-13 Updated To Proper Version
    [BasePlate_V1.ipt, Baseplate_Bottom.dxf, Baseplate_Top.dxf, Baseplate_V1.0009.ipt, Baseplate_V1.ipt, Baseplate_deriveTest.0003.ipt, Baseplate_face.0008.ipt, Baseplate_face.ipt]
2023-08-22 Update Finished version
    New files and reorganization of public folder structure.
    [Baseplate_Bottom.dxf, Baseplate_Top.dxf, Baseplate_V1.0009.ipt, Baseplate_V1.ipt, Baseplate_deriveTest.0003.ipt, Baseplate_face.0008.ipt, Baseplate_face.ipt, Bearing1.0001.iam]
